LXK-98/ipod-classic-reverse-engineering/captures/INDEX.md

# Capture index

Generated by `tools/index_captures.py`. Do not edit by hand.

Captures are stored gzipped (~110:1); every tool loads `.csv` and `.csv.gz`
interchangeably via `tools/capio.py`. Each has a `.json` sidecar recording the
full settings, the probe-map version in force, and a free-text note.

Filenames all carry the `dryrun` preset name because every capture was driven
through that preset with explicit overrides — it is **not** an indication that
the capture is a throwaway. Read the note column.

| capture | rate | ch | samples | bursts | purpose |
|---|---:|---:|---:|---:|---|
| `20260726_171535_dryrun` | 1 MS/s | 2 | 4608 | 1 | Phase 0 pipeline validation. Pico GP15(50pct)->CH1, GP14(25pct)->CH2, GND->GND. Shifter VREF switch=3v3. ModemManager exclusion rule installed. |
| `20260726_171859_dryrun` | 100 MS/s | 2 | 121024 | 1 | 100 MS/s path validation at 1 MHz PWM |
| `20260801_185016_dryrun` | 1 MS/s | 1 | 131024 | 1 | VREF=EXT@1.8V from pin26; GND=pin3; CH1=pin27. Shifter validation, burst envelope. |
| `20260801_185127_dryrun` | 100 MS/s | 1 | 131024 | 1 | pin27 fine structure at 100 MS/s |
| `20260801_191429_dryrun` | 100 MS/s | 22 | 32767 | 1 | Phase 2 survey A: 22 signal pins, 100 MS/s, trigger falling /WR (P27) |
| `20260801_191517_dryrun` | 100 MS/s | 22 | 32576 | 64 | Phase 2 survey B: burst mode, 64 bursts x 508 samples, each armed on falling /WR |
| `20260801_191740_dryrun` | 100 MS/s | 22 | 32767 | 1 | Phase 3: bootloader LCD init capture. Armed before power-on; first falling /WR should be the first write of lcd_init_seq_23. |
| `20260801_192633_dryrun` | 100 MS/s | 24 | 32767 | 1 | Phase 3: bootloader lcd_init_seq_23 capture. 24ch incl. new P30/P32 to hunt the missing bit-4 lane. Armed with iPod OFF; first falling /WR = first … |
| `20260801_193606_dryrun` | 100 MS/s | 24 | 32754 | 7 | Phase 3: LCD wake init (seq_awake = lcd_init_seq_23, 152 writes). 7 bursts: 6 consumed by the NOP prefix, 7th should catch the register block start… |
| `20260801_194824_dryrun` | 100 MS/s | 24 | 32754 | 7 | Phase 3 retry after reseating probes: confirm bits 3,4,5,15 and test whether P09==P14 persists (solder-bridge vs miswire). |
| `20260801_195303_dryrun` | 100 MS/s | 24 | 32754 | 7 | Swap test: pin21 moved from CH15 to CH17 (known-good, previously pin23/bit2). CH15 now unconnected. If P21b shows bit4, the CH13-16 shifter group i… |
| `20260801_200739_dryrun` | 100 MS/s | 24 | 32754 | 7 | LA-B (serial 5033592712586E1F) full 24ch wake init. Expect 11 known lanes to re-match plus bits 3 and 5 on pins 22/20 if LA-B is healthy. |
| `20260801_212943_dryrun` | 100 MS/s | 24 | 32576 | 64 | Post-reflow check: burst capture of ordinary screen activity. D/C (P28, CH21) must toggle if the CH21-24 group is alive. |
| `20260801_213713_dryrun` *(failed, no data)* | 100 MS/s | 24 | 32576 | 64 | Phase 5 colour fill RED, forced redraw by navigation. Expect dominant pixel word 0xF800. |
| `20260801_214113_dryrun` | 100 MS/s | 24 | 32576 | 64 | Phase 5 RED fill retry. Expect dominant data word 0xF800; first real test of predicted bits 14,15 (pins 9,10) and 6 (pin 19). |
| `20260801_215011_dryrun` | 100 MS/s | 24 | 32576 | 64 | Phase 5 GREEN fill: expect 0x07E0 (bit10=1, bit15=0). Discriminates whether pins 9 and 14 are genuinely tied. |
| `20260801_215055_dryrun` | 100 MS/s | 24 | 32576 | 64 | Phase 5 GREEN fill retry (screen currently blue). Expect 0x07E0: bit10=1 AND bit15=0 - the only stimulus that separates pins 9 and 14. |
| `20260801_220743_dryrun` | 100 MS/s | 24 | 32576 | 64 | Phase 5 WHITE fill (0xFFFF): every RGB666 lane should be driven high. Tests all 18 data lanes in the high state, incl. P02. |
| `20260801_220922_dryrun` | 0.2 MS/s | 24 | 32767 | 1 | SLOW WIDE survey at 200 kS/s = 164 ms. Purpose: /CS envelope between bursts, TE period (~66Hz). /WR WILL alias at this rate - do not read fast-sign… |
| `20260801_221938_dryrun` | 20 MS/s | 24 | 32767 | 1 | Frame strip capture: 20 MS/s (guarantees >=1 sample in the 70-80ns /WR low), 32767 samples = 1.64ms = ~2686 pixels = ~8 rows of 320. Reconstruct wi… |
| `20260801_222018_dryrun` | 20 MS/s | 24 | 32767 | 1 | Frame strip retry, display already awake. Scroll the menu to force full redraws. |
| `20260801_222140_dryrun` | 20 MS/s | 24 | 32767 | 1 | Frame strip, LCD sleep disabled so no wake-init prefix. Scroll menu for full redraws. |
| `20260801_222235_dryrun` *(failed, no data)* | 20 MS/s | 24 | 32767 | 2 | Frame strip via 2 bursts x 16383 @20MS/s. Burst 1 absorbs window-setup + memcpy gap; burst 2 should land mid-pixel-stream giving ~1343 contiguous p… |
| `20260801_222433_dryrun` | 20 MS/s | 24 | 32766 | 2 | Frame strip, 2 bursts x 16127 @20MS/s, pre=512 (pre=1 appears to be below the device minimum and never completed). |
| `20260801_222550_dryrun` | 20 MS/s | 24 | 32766 | 1 | Mid-frame strip: contiguous capture armed during continuous scrolling, so the trigger lands on a random pixel mid-frame rather than on the window s… |
| `20260801_223230_dryrun` | 100 MS/s | 24 | 32576 | 64 | INDIGO fill (75,0,130): R5=9=01001, G6=0, B5=16=10000. Determines the blue MSB and constrains red's within-field bit order. |
| `20260801_223514_dryrun` | 100 MS/s | 24 | 32576 | 64 | VIOLET fill (238,130,238): R5=29, G6=32=100000 (ONE green lane high = the green MSB), B5=29. Determines the GREEN within-field bit order. |
| `20260801_223723_dryrun` | 100 MS/s | 24 | 32576 | 64 | ORANGE fill (255,165,0): R5=31->63, G6=41=101001 (positions 5,3,0), B5=0. Resolves which of P01/P18 sits at green position 3 and which of P16/P19/P… |
| `20260801_224147_dryrun` | 100 MS/s | 24 | 32576 | 64 | Custom background R=0 G=16 B=0 (RGB565 units). G6=16=010000 -> exactly one green lane high = the position-4 pin. Resolves P16 vs P19. |
| `20260801_224807_dryrun` | 100 MS/s | 24 | 32576 | 64 | Green status bar at row 0. If it is the R=0 G=16 B=0 setting, exactly one green lane should be high = the position-4 pin, resolving P16 vs P19. |
| `20260802_124256_dryrun` ⛔ **INVALID — EXCLUDE FROM SWEEPS** | 100 MS/s | 24 | 32576 | 64 | **VREF on the 3v3 switch position put the TXU0104 threshold (V(T+) max 1.92 V) above a 1.8 V logic high. 18 of 24 channels read constant 0 with zero edges; the data bus is unreadable. The capture reports success and returns plausible-looking values, so it must be EXCLUDED from any content sweep. See FINDINGS 'A level shifter referenced too high fails silently'. Demonstrated 2026-10-12: including this file in a pair-replication sweep produced 29 spurious blue-pair splits.** |
| `20260802_125222_dryrun` *(failed, no data)* | 1 MS/s | 24 | 32766 | 1 | COLD BOOT /RESET hunt. VREF from a 1k/1k divider off the analyzer 3v3 (1.6V, independent of the target). Armed with the iPod OFF; trigger on P30 fa… |
| `20260802_125453_dryrun` *(failed, no data)* | 1 MS/s | 24 | 32766 | 1 | COLD BOOT /RESET hunt, attempt 2: trigger on P32 falling. P30 did not pulse on a cold boot. VREF from 1k/1k divider off analyzer 3v3 (1.6V). |
| `20260802_125835_dryrun` *(failed, no data)* | 1 MS/s | 24 | 32766 | 1 | COLD BOOT rising-edge timing. Both P30 and P32 sit at 0V while the iPod is off and rise at power-on; a falling-edge trigger could never fire (desig… |
| `20260802_130138_dryrun` *(failed, no data)* | 1 MS/s | 24 | 32766 | 1 | COLD BOOT, trigger on /CS (P29) falling = first LCD transfer, with 30ms PRE-TRIGGER. Captures the state of P30/P32 throughout power-up rather than … |
| `20260802_130335_dryrun` | 100 MS/s | 24 | 32576 | 64 | VALIDATION: does the analyzer read the bus correctly with VREF from the 1k/1k divider (1.6V)? Decode the window-setup commands to confirm before sp… |
| `20260802_130459_dryrun` *(failed, no data)* | 1 MS/s | 24 | 32766 | 1 | COLD BOOT retry, rig now VALIDATED (window-setup commands decode byte-exactly at VREF=1.6V from the divider). Trigger /CS falling, 30ms pre-trigger… |
| `20260802_131144_dryrun` | 100 MS/s | 24 | 32576 | 64 | Post-restore validation (retry after the analyzer dropped off USB). VRF back on pin 26, P07 back on CH3, switch on EXT. |
| `20260802_131348_dryrun` | 20 MS/s | 24 | 32766 | 2 | Final frame reconstruction. 2 bursts x 16127 @20MS/s: burst 1 absorbs the window setup and the memcpy gap, burst 2 lands mid-pixel-stream for ~1340… |
| `20260803_203836_init-burst` | 20 MS/s | 24 | 32764 | 10 | Full 152-write wake init. 10 bursts @20MS/s: 6 NOPs, the 140-write register block, and the 3 trailing pairs after the 30/60/150ms sleeps. |
| `20261012_154402_power-seq` *(failed, no data)* | 1 MS/s | 8 | 131071 | 1 | STAGE 0 pipeline validation, NOT real data. iPod OFF, VRF from 1k/1k divider off analyzer 3v3 (1.6V), switch EXT. Trigger ch0 driven by a manual ju… |
| `20261012_161426_power-seq` *(failed, no data)* | 1 MS/s | 8 | 131071 | 1 | STAGE 0 RIG VALIDATION, not power-seq data despite the preset name. iPod ON (battery, charger out), live screen traffic. VRF from 1k/1k divider off… |
| `20261012_161634_power-seq` | 1 MS/s | 8 | 131071 | 1 | STAGE 0 RIG VALIDATION retry with pre=1024. iPod ON (battery), scrolling. Same rig as the three preceding no-fire attempts; ONLY pre-trigger size c… |
| `20261012_161748_blit-timing` | 20 MS/s | 24 | 32767 | 1 | STAGE 0 RIG VALIDATION, exact replication of the proven 20260801_221938 config (20 MS/s, pre 512, post 32255, 24ch, trigger ch19=P27=/WR falling). … |
| `20261012_165816_power-seq` | 0.1 MS/s | 24 | 32767 | 1 | PRE-FLIGHT after rewiring rails onto silkscreen CH2/CH9/CH19 (pins 26/33/34), retry after the analyzer was unplugged by the operator during rewirin… |
| `20261012_170354_power-seq` | 0.1 MS/s | 24 | 32767 | 1 | GAP 1: RAIL POWER-UP SEQUENCING, first ever capture of pins 26/33/34. Cold start by BATTERY RECONNECT with the iPod previously off and the battery … |
| `20261012_171110_power-seq` | 0.1 MS/s | 24 | 32767 | 1 | GAP 1 REPRODUCIBILITY CHECK, identical method to 20261012_170354: iPod powered off then battery removed, capture armed with all rails at 0, cold st… |
| `20261012_171537_power-seq` | 0.1 MS/s | 24 | 32767 | 1 | GAP 1 REPEAT via HOLD-SWITCH cold start, a better method than battery reconnect. Sequence: battery out -> hold switch LOCKED -> battery in (firmly … |
| `20261012_172903_power-seq` | 0.025 MS/s | 24 | 32767 | 1 | GAP 2: rail to first command. 25 kS/s x 32767 = 1.31 s window (20.5ms pre, 1290ms post) at 40us resolution, same wiring as gap 1, trigger = 3.0V ra… |
| `20261012_210039_power-seq` *(failed, no data)* | 0.005 MS/s | 24 | 32767 | 1 | POWER-DOWN SEQUENCING, first ever capture of this. 5 kS/s x 32767 = 6.55 s window (102ms pre, 6451ms post) at 200us resolution. Trigger = VDDIO (V1… |
| `20261012_210640_power-seq` | 0.025 MS/s | 24 | 32767 | 1 | POWER-DOWN SEQUENCING, first ever capture of this. 25 kS/s (the slowest rate this project has actually got data from; 5 kS/s silently failed to arm… |

## ⛔ Captures that must be excluded from analysis

These completed successfully and contain plausible-looking data that is
nonetheless wrong. Nothing about the capture itself signals this, so any
content sweep must skip them — use `capio.invalid_reason()`.

- **`20260802_124256_dryrun`** — VREF on the 3v3 switch position put the TXU0104 threshold (V(T+) max 1.92 V) above a 1.8 V logic high. 18 of 24 channels read constant 0 with zero edges; the data bus is unreadable. The capture reports success and returns plausible-looking values, so it must be EXCLUDED from any content sweep. See FINDINGS 'A level shifter referenced too high fails silently'. Demonstrated 2026-10-12: including this file in a pair-replication sweep produced 29 spurious blue-pair splits.
