LXK-98/ipod-classic-reverse-engineering/hardware/interposer/display-analyzer-board.kicad_pcb

## KiCad design hardware/interposer/display-analyzer-board.kicad_pcb (2026-08-01)

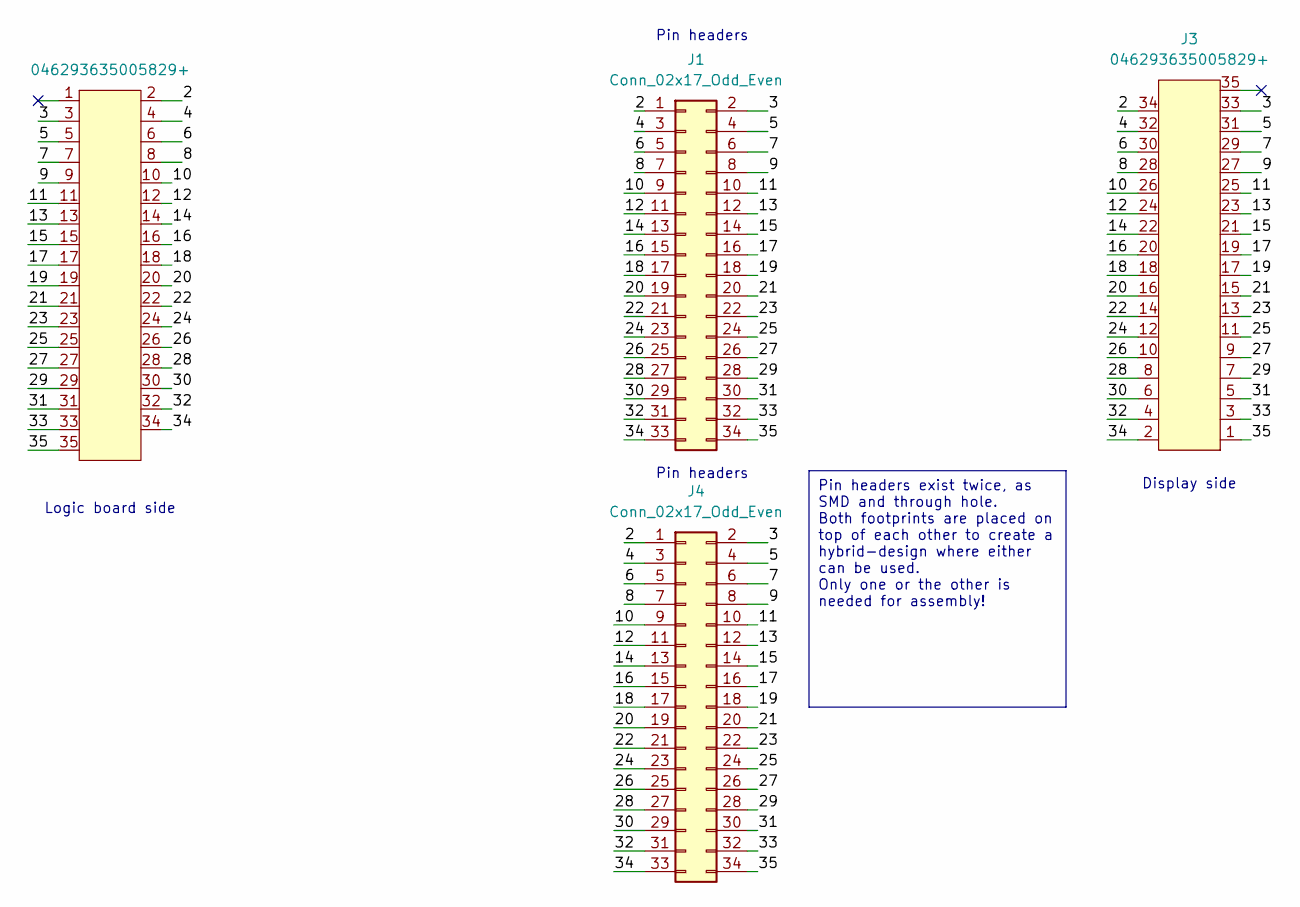
[picture p1: schematic display-analyzer-board.kicad_sch, iPod Classic 7 Gen Display signal interceptor board]

Parts:
J1: Conn_02x17_Odd_Even; PinHeader_2x17_P2.54mm_Vertical_SMD
J2, J3: 046293635005829+
J4: Conn_02x17_Odd_Even; PinHeader_2x17_P2.54mm_Vertical

Connections:
/2: J1.1, J2.2, J3.34, J4.1
/3: J1.2, J2.3, J3.33, J4.2
/4: J1.3, J2.4, J3.32, J4.3
/5: J1.4, J2.5, J3.31, J4.4
/6: J1.5, J2.6, J3.30, J4.5
/7: J1.6, J2.7, J3.29, J4.6
/8: J1.7, J2.8, J3.28, J4.7
/9: J1.8, J2.9, J3.27, J4.8
/10: J1.9, J2.10, J3.26, J4.9
/11: J1.10, J2.11, J3.25, J4.10
/12: J1.11, J2.12, J3.24, J4.11
/13: J1.12, J2.13, J3.23, J4.12
/14: J1.13, J2.14, J3.22, J4.13
/15: J1.14, J2.15, J3.21, J4.14
/16: J1.15, J2.16, J3.20, J4.15
/17: J1.16, J2.17, J3.19, J4.16
/18: J1.17, J2.18, J3.18, J4.17
/19: J1.18, J2.19, J3.17, J4.18
/20: J1.19, J2.20, J3.16, J4.19
/21: J1.20, J2.21, J3.15, J4.20
/22: J1.21, J2.22, J3.14, J4.21
/23: J1.22, J2.23, J3.13, J4.22
/24: J1.23, J2.24, J3.12, J4.23
/25: J1.24, J2.25, J3.11, J4.24
/26: J1.25, J2.26, J3.10, J4.25
/27: J1.26, J2.27, J3.9, J4.26
/28: J1.27, J2.28, J3.8, J4.27
/29: J1.28, J2.29, J3.7, J4.28
/30: J1.29, J2.30, J3.6, J4.29
/31: J1.30, J2.31, J3.5, J4.30
/32: J1.31, J2.32, J3.4, J4.31
/33: J1.32, J2.33, J3.3, J4.32
/34: J1.33, J2.34, J3.2, J4.33
/35: J1.34, J2.35, J3.1, J4.34

Notes on the sheet:
Pin headers exist twice, as SMD and through hole. Both footprints are placed on top of each other to create a hybrid-design where either can be used. Only one or the other is needed for assembly!
Pin headers
Display side
Logic board side

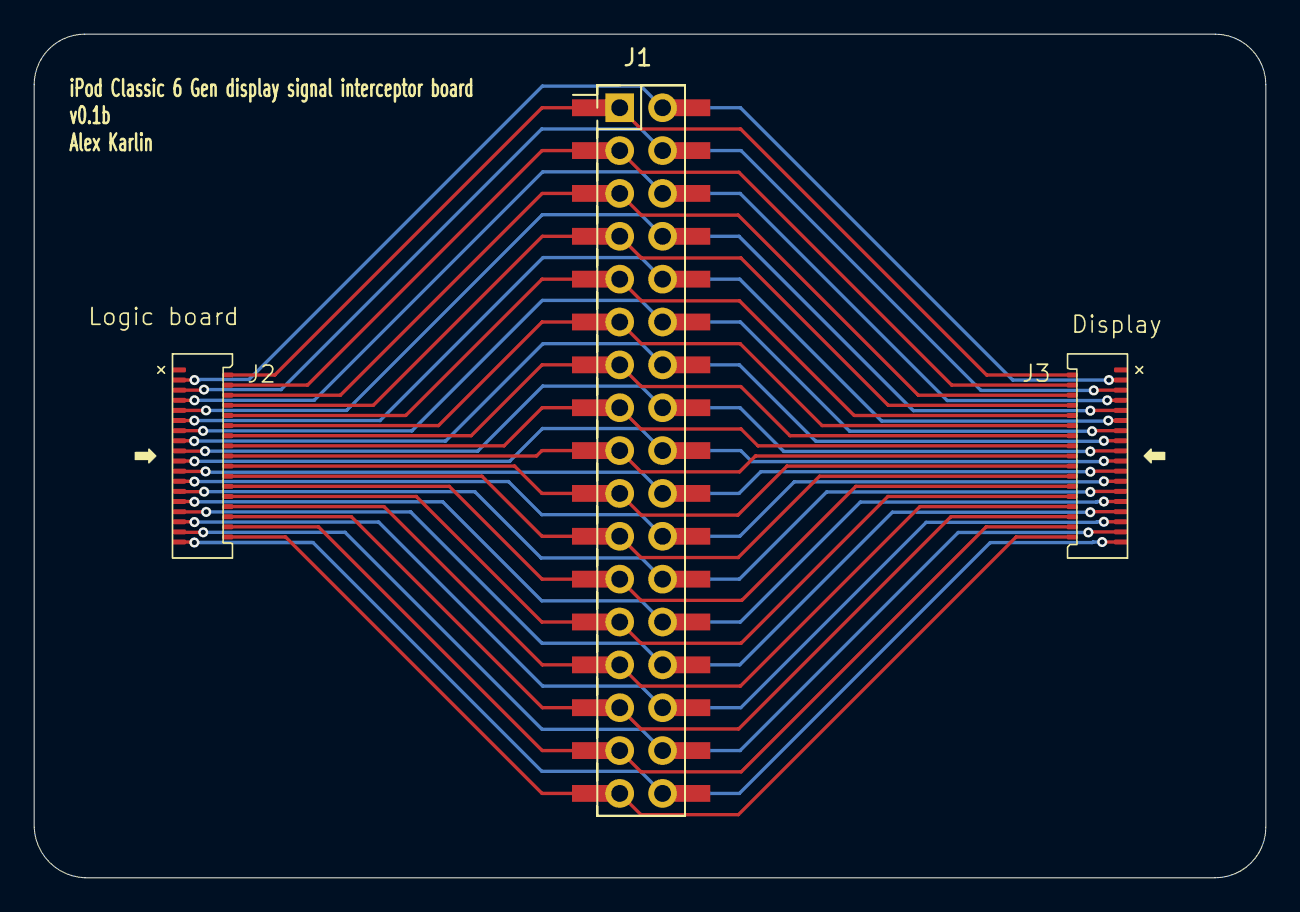
[picture p2: board display-analyzer-board.kicad_pcb from above]

Board: 2 copper layers, 73.0 x 50.0 mm, 4 parts (0 on the bottom side), 34 nets.
