LXK-98/ipod-classic-reverse-engineering/tools/index_captures.py

#!/usr/bin/env python3
# SPDX-License-Identifier: MIT
"""Regenerate captures/INDEX.md from the capture sidecars.

Capture filenames are timestamps and carry no meaning; the sidecar JSON records
what each one was for, the settings used, and the probe map in force. This turns
that into a readable table so the evidence set is navigable.
"""
from __future__ import annotations

import json
from pathlib import Path

REPO = Path(__file__).resolve().parent.parent
CAP = REPO / "captures"


def main() -> int:
    rows = []
    for j in sorted(CAP.glob("*.json")):
        d = json.loads(j.read_text())
        s = d.get("session", {})
        stem = j.stem
        data = next((p.name for p in (CAP / f"{stem}.csv.gz", CAP / f"{stem}.csv") if p.exists()), None)
        n_ch = len(s.get("CaptureChannels", []))
        total = s.get("PostTriggerSamples", 0) * (s.get("LoopCount", 0) + 1) + s.get("PreTriggerSamples", 0)
        rows.append({
            "id": stem,
            "ok": bool(data),
            "rate": s.get("Frequency"),
            "ch": n_ch,
            "samples": total,
            "bursts": s.get("LoopCount", 0) + 1,
            "note": (d.get("note") or "").strip(),
            "probe_map": d.get("probe_map", ""),
            "invalid": bool(d.get("invalid")),
            "invalid_reason": (d.get("invalid_reason") or "").strip(),
        })

    out = ["# Capture index", "",
           "Generated by `tools/index_captures.py`. Do not edit by hand.", "",
           "Captures are stored gzipped (~110:1); every tool loads `.csv` and `.csv.gz`",
           "interchangeably via `tools/capio.py`. Each has a `.json` sidecar recording the",
           "full settings, the probe-map version in force, and a free-text note.", "",
           "Filenames all carry the `dryrun` preset name because every capture was driven",
           "through that preset with explicit overrides — it is **not** an indication that",
           "the capture is a throwaway. Read the note column.", "",
           f"| capture | rate | ch | samples | bursts | purpose |",
           "|---|---:|---:|---:|---:|---|"]
    for r in rows:
        rate = f"{r['rate']/1e6:g} MS/s" if r["rate"] else "—"
        note = r["note"].replace("|", "/")
        if len(note) > 150:
            note = note[:147] + "…"
        mark = "" if r["ok"] else " *(failed, no data)*"
        if r["invalid"]:
            mark = " ⛔ **INVALID — EXCLUDE FROM SWEEPS**"
            note = f"**{r['invalid_reason'].replace('|', '/')}**"
        out.append(f"| `{r['id']}`{mark} | {rate} | {r['ch']} | {r['samples']} | "
                   f"{r['bursts']} | {note} |")
    out.append("")

    bad = [r for r in rows if r["invalid"]]
    if bad:
        out += ["## ⛔ Captures that must be excluded from analysis", "",
                "These completed successfully and contain plausible-looking data that is",
                "nonetheless wrong. Nothing about the capture itself signals this, so any",
                "content sweep must skip them — use `capio.invalid_reason()`.", ""]
        for r in bad:
            out.append(f"- **`{r['id']}`** — {r['invalid_reason']}")
        out.append("")

    (CAP / "INDEX.md").write_text("\n".join(out) + "\n")
    ok = sum(1 for r in rows if r["ok"])
    n_bad = len(bad)
    extra = f", {n_bad} INVALID (exclude from sweeps)" if n_bad else ""
    print(f"wrote captures/INDEX.md — {len(rows)} sidecars, {ok} with data{extra}")
    return 0


if __name__ == "__main__":
    raise SystemExit(main())
