LXK-98/ipod-classic-reverse-engineering/(commit log)

2026-07-26 Phase 0: repo scaffold, Rockbox ground truth, capture toolchain
    - refs/: Rockbox lcd-6g.c, lcd-s5l8702.c + headers (pinned by sha256)
    - tools/rockbox_seq.py: expands init/sleep/awake sequences to byte-exact
    bus transactions for all 4 panel types x 2 build configs
    - tools/capture.py: TerminalCapture wrapper (CLCapture is gone in v6.0.0.1)
    - pinout.json v0, findings.md
2026-07-26 Phase 0 complete: pipeline validated against known signal
    - classify.py: per-channel stats, whole-cycle duty, median pulse widths
    - picogen.py: persistent main.py generator (PWM was being GC-deinited)
    - docs/99-bench-instruments.rules: ModemManager was wedging BOTH instruments
    - acceptance: 10kHz and 1MHz references match at 0.000% freq error
    [capture.py, classify.py, picogen.py]
2026-08-01 Fix pin convention from interposer KiCad: flex is 34-pin, not 33
    Parsed the collaborator's own board netlist. Connectors are 35-position
    with the topmost unused; all 34 routed nets /2../35 are live.
    FLEX pin N = header pin N = net /(N+1), N = 1..34
    header pin 1 = TOP-LEFT, odd = left column, even = right
    Corrects the project brief's 33-pin figure and rebuilds pinout.json.
    [display-analyzer-board.kicad_pcb, display-analyzer-board.kicad_sch]
2026-08-01 Untrack KiCad caches, backups and embedded .history repo
2026-08-01 Phase 1: ground reference established, two distinct grounds found
    Signal ground (HDD case + several LCD flex pins, mutually ~0 ohm) is
    bonded to chassis ground (dock shell, rear shell) through ~300 ohm.
    Contact resistance ruled out: both metals read ~0 ohm across themselves.
    Consequence: analyzer ground must go to signal ground (a GND pin on the
    interposer header), not chassis, or 300 ohm sits in the return path.
2026-08-01 Phase 1: ground sweep shows clear pin clustering
    GND = 3,6,8,17,31. Pin 5 at 25.6 ohm = backlight cathode candidate.
    17 pins share an identical 3.7-3.8M leakage (data bus?), 6 pins sit at
    0.5-0.6M (control set is exactly 6 signals). Budget closes at 34.
    Also: beeper mode hid all structure above ~50 ohm; resistance-range
    readings supersede it. tools/record_dmm.py ingests sweeps to pinout.json.
    [2026-08-01_ground-sweep.tsv]
2026-08-01 Phase 1: backlight identified (pin 4 = 10.7V), VDDIO ~1.8V
    SAFETY: pin 4 is the backlight anode at 10.7V and must never touch an
    analyzer input (TXU0104 A-side max 5.5V). Rule 1 satisfied.
    VDDIO ~1.8V trips the brief's 2.3V gate. Shifter VREF MUST move from
    3v3 to EXT: at VCCI=3V the TXU0104 VT+ max is 1.92V, above a 1.8V
    logic high, so probing on 3v3 would give intermittent wrong data.
    Pin structure now closes: 18 bus + 4 active-low control + 5 GND +
    4 rails + BL+ + 1 unresolved = 34.
    [2026-08-01_powered-sweep.tsv]
2026-08-01 Phase 1 complete: /WR identified on pin 27, bus timing measured
    VREF=EXT@1.8V validated. Pin 27 = /WR: 70-80ns low, 530-540ns high,
    610ns cycle, 1.64 MHz. Burst span 46.92ms vs 76800 px x 610ns =
    46.85ms (0.1% match) => full-frame update, ONE transfer per pixel,
    confirming LCD_MODE_P16 RGB565/1-transfer which Rockbox marks TBC.
    Also recorded: a 1 MS/s capture aliased 1.64 MHz into a fake, very
    regular 91 kHz. Run-length regularity is NOT evidence against
    aliasing - the survey preset's 10 MS/s would have mis-measured this.
2026-08-01 First real bus decode: D/C found, 3 lanes mapped, bit-4 lane missing
    Caught displaylcd_setup() (13 writes = 6 reg+data pairs + bare 0x202).
    P28 = D/C (0=cmd, 1=data). P25=bit0, P24=bit1, P15=bit9 from the seven
    known command words.
    ANOMALY: bit 4 (signature 1111000 over the commands) appears on no
    probed pin. Hypothesis: one of pins 26/30/32, classified as 1.8V rails
    from DMM, is a mostly-high data lane - bursts are only 4.7% of wall
    time so a DMM averages such a lane to ~1.8V.
    Also flagged: P15 as 'bit 9' is degenerate with 'inverted D/C' in this
    sequence; the init sequence breaks the tie.
2026-08-01 Cold-boot capture fails: VREF is derived from the target's own rail
    All 24 channels flat zero. With the iPod off, pin 26 (VRF source) is
    0V, so TXU0104 Ioff-float forces outputs high-Z and the collapse itself
    trips the falling-edge trigger.
    Fix: trigger the init via LCD sleep/wake (Rockbox
    lcd_sleep_after_backlight_off) with the iPod powered throughout. Type 2
    sets seq_awake = lcd_init_seq_23, so waking replays a full 152-write
    init with a 6x NOP prefix signature.
    Fallback if the rail drops during sleep: divider from analyzer 3v3.
2026-08-01 LANE MAP SOLVED: 10 data lanes + D/C + /WR matched exactly
    Wake capture came out exactly as designed: bursts 1-6 = one NOP each,
    burst 7 = 69 consecutive register writes. Matched against
    lcd_init_seq_23 (firmware) with 2^-69 false-match probability.
    bit0=p25 bit1=p24 bit2=p23 bit7=p18 bit8=p16 bit9=p15
    bit10=p14 bit11=p13 bit12=p12 bit13=p11
    /WR=p27 D/C=p28 (0=cmd, 1=data)
    All fit a monotonic descending pin->bit run that skips GND pins 17/8,
    predicting p22..p19 = bits 3..6 and p10/p9 = bits 14/15.
    P15 degeneracy resolved: genuinely bit 9, not inverted D/C.
    Two wiring faults isolated: P09==P14 byte-identical (CH4 landed on
    pin 14), and pins 20/21/22 read constant 0 though bits 5/4/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
2026-08-01 Reseat changes nothing: probe-path fault, likely one dead TXU0104
    Bit-identical re-capture rules out intermittent contact. The powered
    DMM sweep already showed pins 19-22 toggling, so the interposer is
    fine and the break is between header and analyzer.
    CH13-16 are exactly one 4-bit TXU0104 group (6 chips x 4 = 24ch), and
    all four fail together - consistent with an unsoldered VCC/GND on one
    device, whose Ioff-float behaviour gives clean constant 0.
    Channels proven good by exact ground-truth match: CH6-12, CH17-21.
    P09==P14 still unexplained; does not fit the dead-group theory.
2026-08-01 Swap test: dead TXU0104 confirmed, pin21=bit4 verifies predicted map
    Pin 21 reads constant 0 on CH15 but matches bit4 EXACTLY on CH17.
    CH13-16 is one 4-bit TXU0104 group => one dead translator, not a
    board or probe fault.
    pin21=bit4 was PREDICTED by the monotonic pin->bit rule and verified
    exactly; the rule now has 11 confirmed instances, 0 exceptions.
    Unconnected CH15 read 0/68 ones, proving floating channels read zero
    rather than mirroring - which rules out crosstalk for P09==P14.
2026-08-01 LA-B: bits 3,5 confirmed; both analyzers have a dead TXU0104 group
    P22=bit3, P20=bit5 exact matches. All 13 bits the init can exercise
    are now confirmed, vindicating the dead-CH13-16 diagnosis.
    LA-B has its own dead group CH21-24 (P30/P32 read const 1 on LA-A but
    const 0 here - dead channel, not changed signal). Neither is blocking:
    20 good channels covers 18 data + WR + DC.
    P09==P14 persists across a different analyzer with re-run wiring.
    Remaining: bits 6/14/15 need colour fills - they are constant zero in
    the entire init sequence, as predicted from source.
2026-08-01 Analyzer repaired: OE cold joint on pin 8, reflow fixed it
    Supplies measured 3.3V everywhere, ruling out unsoldered VCC. Traced
    instead to OE (pin 8), which gates ALL FOUR outputs high-Z when
    floating - matching the dead-group-of-4 signature exactly. OE sits
    next to GND at one end of the TSSOP, the corner drag-soldering
    skimps.
    Post-reflow: P28/P29 alive; P30/P32 read const 1, matching LA-A's
    reading of the same pins when healthy. LA-B now has all 24 channels.
    Also recorded the V2 chip->channel map, which is NOT in sequential
    physical order: U1,U4,U6,U5,U3,U2 top-to-bottom = CH1-4, 21-24, 5-8,
    17-20, 9-12, 13-16.
2026-08-01 Colour fills: bit 6 confirmed, bit 10 anomaly is real and reproducible
    Lamp plugin palette is hard-coded, so expected words are exact.
    Blue decodes exactly 0x001F. Red and green are each wrong by exactly
    one bit - bit 10 - in opposite directions. No palette colour produces
    the observed words, so the reading is corrupted, not the colour.
    Red and green are the ONLY lamp colours where bit15 != bit10, and both
    show pin 14 taking pin 9's value.
    Unexplained contradiction: a short with bit15 winning fits the fills
    but not the init, where bit15 is constant 0 yet P09/P14 tracked the
    varying bit 10 across 68 writes.
    bit 6 = pin 19 CONFIRMED (0x00EF decodes correctly only with it).
    [decode8080.py]
2026-08-01 The bus is RGB666, not RGB565 - bit-10 anomaly was my analysis error
    Pins 9/14 measure 6.66M (open) and wiring is confirmed correct, ruling
    out hardware. Solved frame-mode mapping empirically from the lamp
    fills instead: red/green/blue each drive exactly SIX lanes.
    RED pins 9,10,11,12,13,14
    GREEN pins 1,15,16,18,19,20
    BLUE pins 2,21,22,23,24,25
    I had decoded pixels with the 16-bit command-mode map, which is the
    wrong model and manufactured a phantom one-bit error in exactly the
    two fills where the fields disagree.
    P09==P14 is the red channel's 5->6 expansion duplicate. Predicted a
    blue duplicate too; there is none, so the expansion is asymmetric and
    the model is incomplete.
    Cont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
2026-08-01 White fill closes the 18-lane RGB666 inventory (6/6/6)
    All 18 data lanes high on white, including P02. Lanes now observed in
    both states. P07/P29/P30/P32 did not follow the pixel data.
    32 of 34 pins assigned. Only 7 and 29 unassigned - but four control
    signals remain to place, so the 'rail' classification of pins 30/32 is
    likely wrong: an idle-high control line reads a steady 1.8V on a DMM.
    Pin 7 = TE hypothesis: the first powered sweep saw ~15ms (~66Hz)
    spikes there, a panel refresh rate. Pin 29 constant-low fits /CS.
2026-08-01 PINOUT COMPLETE: TE on pin 7, /CS on pin 29, all 34 pins assigned
    Slow 200 kS/s survey exposed the signals that are constant inside a
    325us burst window:
    pin 7 = TE - 60us pulse every 14.72ms = 67.9 Hz (refresh rate)
    pin 29 = /CS - idles high, low envelopes framing write bursts
    pins 30,32 = /RD and /RESET by elimination (order undetermined)
    Adds tools/report.py, which regenerates PINOUT.md from pinout.json.
    28 pins high confidence, 5 medium, 1 low (pin 34 analog node).
    [report.py]
2026-08-01 Add frame2png.py: reconstructs images from captures, validates protocol
    Decoder reproduces the lamp plugin's colours byte-exactly on all four
    fills (red/green/blue/white -> pure RGB888). Validates pin assignment,
    RGB666 field mapping, /WR latch edge and D/C polarity by
    reconstruction rather than pattern matching.
    Recovers the update rect from the 0x210-0x213 window commands, so
    geometry comes from the capture. PNG written with stdlib zlib only.
    Full frames are out of reach: 46.9ms at >=20 MS/s needs ~940k samples
    vs 131k max, short by ~7x. Partial strips work fine.
    [frame2png.py]
2026-08-01 P09==P14 SOLVED: P14 is a hardware replica of the red MSB
    Collaborator reported the screen top is grey; we decoded green. Saturated
    fills cannot validate bit order WITHIN a field - that had been assumed.
    Indigo (non-saturated: R5=01001, B5=10000) shows both 5-bit channels
    gaining one extra high lane => the 5->6 expansion replicates the MSB
    into the LSB: 6bit = (5bit<<1)|(5bit>>4)
    RED = P09 P10 P11 P12 P13 P14 (P14 replicates P09)
    BLUE = P21 P22 P23 P24 P25 P02 (P02 replicates P21)
    This resolves P09==P14 completely: not a short, not a miswire, not
    crosstalk. P14 carries a hardware copy of P09. It also explains the
    command-vs-frame contradiction (P14 = APB bit 10 in command mode,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
    [frame2png.py]
2026-08-01 Backlight fully characterised: 19.5 mA into ~3 white LEDs
    500 mV flat across the 25.6 ohm sense resistor at max brightness =
    19.53 mA true DC current (flat => 100% duty). At brightness 7, 27.1 mV
    = 1.06 mA average at ~5.4% duty, same peak.
    => dimming is PWM at constant peak current; colour temperature stays
    constant. Brightness curve is perceptual (gamma ~1.3), not linear.
    String: 10.7V anode - 0.5V sense = ~10.2V => ~3 white LEDs in series.
    Phase 6 spec: constant-current boost, ~20 mA, >=11 V compliance, PWM
    dimming. Deliverable #3 complete.
2026-08-01 Fix report.py after backlight data restructure
    [report.py]
2026-08-01 Correction: backlight is 4 LEDs, not 3 (anode is 12.76V at full brightness)
    Re-read pin 4 at brightness 63: 12.76 V, vs 10.7 V at brightness 7.
    Minus the 0.50 V sense drop leaves 12.26 V across the string:
    4 LEDs -> 3.07 V each (textbook white-LED Vf at 20 mA)
    3 LEDs -> 4.09 V each (out of range)
    The earlier 3-LED estimate came from the 10.7 V reading taken at ~5%
    duty, where the boost is lightly loaded - a component count derived
    from the wrong operating point.
    Also: the anode stays up at low duty, so PWM switches the LOW side.
    Driver spec now: ~20 mA into a 4-LED string, >=14 V compliance.
2026-08-01 Reorganise as a publishable project with full documentation
    Documentation:
    README.md front door: results, layout, quick start, safety
    docs/HARDWARE.md target, interposer, instrumentation, safety rules
    docs/PROTOCOL.md bus protocol, init sequences, timing, pixel format
    docs/METHODOLOGY.md how each result was obtained and how to reproduce
    docs/FINDINGS.md notable findings incl. contradictions with Rockbox
    docs/OPEN-QUESTIONS.md what remains unresolved
    docs/LAB-NOTEBOOK.md full chronological log (was findings.md)
    Structure:
    display-analyzer-board/ -> hardware/interposer/
    captures gzipped (37 MB -> 456 KB, ~110:1) with transparent .gz suppor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
    [display-analyzer-board.kicad_pcb, display-analyzer-board.kicad_sch]
2026-08-02 Pin 34 RESOLVED: analog reference INPUT, ~1.54 V, board-supplied
    With the display flex disconnected the logic board still holds pin 34
    at ~1.54 V, so the panel receives it rather than generating it. A
    replacement driver must supply it.
    Also: everything previously reported as activity on this pin - a
    '~80 us square wave', '~12.5 kHz ripple', a 125 Hz readout and bursts
    of ringing - was CHARGER NOISE. It vanishes on battery and returns when
    charging. The pin carries no signal.
    The tell in hindsight: a signal whose apparent period changes with the
    timebase you view it at is not a signal. Recorded as finding 11 -
    take analog measurements on battery power.
2026-08-02 Soft reset does not assert the panel reset line
    Armed on P30 then P32, falling edge, 32.7ms window with 8ms pre-trigger,
    Menu+Select reboot each time. Neither pulsed.
    => the panel's reset is asserted only at cold power-on (PMU rail
    sequencing), not by the SoC on a warm reboot. A replacement driver must
    therefore drive reset itself at power-up.
    Also recorded: a resistive divider cannot supply VREF for a cold-boot
    capture. It reads 0.60 V - a junction drop - because with the iPod
    powered down the TXU0104 A-side inputs are clamped to a dead board,
    presenting ~2.9 kohm on VCCA. Needs a stiff source (LDO or shunt
    reference), not a divider.
2026-08-02 VREF at 3v3 fails quietly: 18 of 24 channels read constant zero
    Tested the switch on 3v3 (which would have solved the cold-boot VREF
    problem) against known traffic. The entire data bus reads flat zero -
    at VCCI=3.3V the TXU0104 VT+ max is 1.92V, above a 1.8V logic high.
    Failure mode is the notable part: the capture reported success and
    returned plausible values (0x0000, 0x0010) with no error. Only the
    absence of the known window-setup commands revealed it. Testing
    against known-answer data is what caught it.
    Cold boot therefore needs a stiff ~1.8V source: 3x 1N4148 + 1k, a red
    LED + 1k, or a 1.8V LDO. A divider remains ruled out.
2026-08-02 Park /RD vs /RESET after five failed boot captures
    Attempts 1-3 used a falling-edge trigger on lines that sit at 0V while
    the iPod is off and RISE at power-on - a test that could not have
    fired. Attempts 4-5 triggered on /CS falling and also did not fire,
    including one after validating that the rig decodes the window-setup
    commands byte-exactly at VREF=1.6V.
    The /CS non-trigger during cold boot remains UNEXPLAINED: /CS visibly
    frames every write burst when the iPod runs.
    Established along the way:
    - the panel is NOT reset on a warm reboot; a driver must drive reset
    - a 10k divider on VRF fails (0.60V, ~2.9k ESD clamp when target off)
    - a 1k divider holds 1.6V and is validated as a wo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
2026-08-02 Restore documented rig configuration; note analyzer USB drop-outs
    VRF back on header pin 26, P07 back on CH3, switch on EXT. Validated:
    the window-setup commands decode byte-exactly, so the bench matches the
    configuration every documented result was taken with.
    Also recorded: the analyzer dropped off the USB bus twice in one
    session. A capture armed when that happens is indistinguishable from
    'the trigger never fired', which may bear on the inconclusive
    cold-boot attempts. Check --list-ports before treating a non-trigger
    as a fact about the target.
2026-08-02 Add reconstructed status-bar image as end-to-end proof
    Rows 0-3 of a live Rockbox screen decoded from a raw bus capture:
    blue icon, text glyph tops, and the battery outline with its red
    low-charge fill - matching what is physically on the panel.
    57 distinct colours across 1320 pixels, no post-processing. Embedded in
    README and PROTOCOL.md as visual confirmation that the pinout, RGB666
    field mapping, /WR latch edge and D/C polarity are all correct.
2026-08-02 Visual confirmation against the physical panel
    Collaborator confirms the reconstructed strip is recognisable as the
    top of the status bar with correct colours.
    This validates the 34-pin map, RGB666 field assignment AND within-field
    bit order, the /WR latch edge, D/C polarity and the window geometry
    decode simultaneously - an error in any would visibly scramble it.
    Categorically stronger than the earlier checks: those compared captures
    against our own predictions, which share a failure mode where a
    consistent error passes unnoticed. That is how the bit-order bug
    survived nine byte-exact protocol matches.
2026-08-02 Add DRIVING.md: complete Phase 6 implementation guide
    Audited the docs against what building a driver actually requires and
    found gaps. Three were closable from existing 100 MS/s captures without
    touching the bench:
    data setup before the /WR latch: min 30 ns, typically 60-70 ns
    data hold after the latch: min 270 ns
    D/C setup before the latch: min 380 ns
    /CS: held low for the whole burst (99.6% low), not toggled per write
    DRIVING.md collects supplies (incl. the easily-missed 1.54V reference on
    pin 34), reset handling, bus timing, RGB666 format, backlight spec, the
    init sequence with usable pseudocode, the blit procedure, and TE sync.
    It also lists five KNOWN GAPS explici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
2026-08-02 Scope the RGB666 claims to what was actually measured
    Prompted by the fair question: how do we know we are right and Rockbox
    is wrong? Largely we do not - the claim needed narrowing.
    What IS measured: all 18 lanes are observed both high and low across
    solid-colour fills, so none is undriven. That contradicts the
    APB[15:0] -> D[17:10,8:1] description at the level of behaviour, and
    holds regardless of pin naming.
    What was overclaimed and is now corrected:
    - 'Rockbox is wrong' -> that comment block is headed 'XXX: WIP, TBC'
    and their driver is correct regardless; nothing depends on it
    - 'D9 and D0 are driven' -> we have NO mapping from our flex pin
    numbers to the SoC's D0-D17, so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
2026-08-03 Document the burst-sizing tradeoff and the failed init-capture attempts
    The burst-boundary write-drop tradeoff existed only in the lab notebook,
    not in METHODOLOGY where someone repeating the work would look. It is
    the key sizing decision: the device re-arms after each burst and can
    lose a write at every boundary, which destroys alignment for sequence
    matching and shears reconstructed images.
    Also adds an explicit 'attempts that failed' section covering the three
    ways the init capture went wrong: arming before a cold boot (VREF
    collapses with the target), a contiguous capture landing inside the
    7.7 ms NOP prefix, and triggering on /WR from an idle screen (which
    catches displaylcd_setup rath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
    [lcsc-order.csv]
2026-08-03 Two write regimes, a wrong claim corrected, and the init was already captured
    Pure analysis of existing captures -- no bench work, the Phase 6 parts have
    not arrived.
    Resolves the 7-vs-13 window-setup question raised in the previous commit, and
    it resolves against something I asserted there. All 13 writes did happen. D/C
    makes 13 transitions in the pattern 0,1,0,1,...,0 across the region -- one run
    per write, starting and ending on a command, exactly the shape of
    displaylcd_setup() -- while only 7 /WR pulses were sampled.
    CORRECTION: "158 falling edges and 158 rising edges, so no pulse was missed"
    is wrong reasoning. A pulse shorter than the sample interval takes both its
    edges with it, so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
    [seqmatch.py]
2026-10-12 The cold-boot captures never armed: an oversized pre-trigger, not the hardware
    A pre-trigger above 1024 samples makes the analyzer silently fail to arm. It
    reports nothing: TerminalCapture prints the same line whether it is waiting for
    a trigger, downloading, or refusing the configuration, and capture.py ran it
    with no timeout. The failure therefore looks exactly like patience running out.
    Confirmed by controlled test. 20261012_161426 and 20261012_161634 are identical
    - 8 channels, 131071 total samples, same trigger channel, 1 MS/s, same rig and
    session - and differ only in pre-trigger, 65536 against 1024. The first sat
    armed 128 s with TE demonstrably pulsing and never fired; the second co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
    [capture.py]
2026-10-12 Gap 1 answered: the analog domain is powered 218 ms before the logic domain
    First capture of pins 26, 33 and 34 in this project. The original board does
    not bring the panel's supplies up together - it runs two phases, reproduced
    across two cold starts to within one 10 us sample:
    0 3.0 V panel supply (pin 33)
    +0.09 ms pin 32
    +0.13 ms 1.54 V analog reference (pin 34)
    +218.3 ms 1.8 V VDDIO (pin 26), with /WR and /CS
    +218.31 ms pin 30
    Every transition is single and monotonic - no glitching, no brown-out. The
    218.3 ms interval held to 0.005% across boots started by *different*
    mechanisms, battery reconnect and hold-switch release, which rules out software
    jitte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
2026-10-12 Gap 2 answered: first LCD transfer 397 ms after VDDIO, and burst duration is measurable
    Slowed the same wiring to 25 kS/s for a 1.31 s window. Boot display timeline,
    from /CS envelopes, timed from the 3.0 V rail:
    +218.28 ms VDDIO up, /WR and /CS rise with it
    +615.64 ms first LCD transfer - /CS asserted 80 us, the init register block
    +628.12 ms TE starts, 67.91 Hz from its very first pulse
    +877.56 ms /CS asserted 40 us, the init's trailing writes
    +879.52 ms first pixel burst, 23.48 ms
    Gap 2's answer is +397.36 ms after VDDIO, and it imposes no driver requirement
    - that is simply when Rockbox's bootloader got round to it. The delay a driver
    must actually respect is the po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
2026-10-12 Withdraw the pre-trigger explanation: the documented limits say it cannot be right
    b7c0054 claimed an oversized pre-trigger is what makes the analyzer silently
    fail to arm. Upstream publishes exact limits (04/02/2023), and against them the
    claim does not hold. Min pre 2, min post 512, frequency 3.1 kHz to 100 MHz:
    mode max pre max post max total
    8 channels 98 303 131 069 131 071
    16 channels 49 151 65 533 65 535
    24 channels 24 576 32 765 32 767
    So pre=65536 at 8 channels was legal and failed twice; pre=8000 at 24 channels,
    three of the five cold-boot attempts, was legal too. Only the pre=30000 pair
    genuinely exceeded a ceiling.
    The de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
    [capture.py]
2026-10-12 Power-down measured: the exact mirror of power-up, over 46.5 ms
    First capture of the panel losing power. Times relative to VDDIO falling, on a
    Rockbox software shutdown with the charger disconnected:
    0 VDDIO falls; /WR, /CS and D/C fall in the SAME 40 us sample
    +32.88 ms 1.54 V analog reference
    +34.04 ms pin 32
    +46.48 ms 3.0 V panel supply
    +47.08 ms pin 30
    Up is 3.0 V -> reference -> VDDIO; down is VDDIO -> reference -> 3.0 V. The
    rails reverse exactly, so the conservative rule a designer would guess - up in
    one order, down in reverse - is what the hardware actually does. The descent
    takes 46.5 ms against 218 ms rising. All transitions single and monotonic.
    Ver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
2026-10-12 README: surface the power sequencing results on the front page
    The status line and the facts table still described the state before today,
    with no mention of power sequencing in either direction. Adds rows for the
    power-up and power-down order, the first-LCD-write delay, and the measured
    pixel burst duration with its ambiguity intact, and points the reader at the
    RGB666 pair test as the open item that still blocks a driver board.
2026-10-12 Correct the record: today's USB disappearances were unplugs, not drop-outs
    The analyzer vanished from USB twice during the 2026-10-12 session, and I
    recorded one of them in a capture note as a spontaneous drop-out. Both were the
    operator physically unplugging it while changing probe wiring. Fixed the note
    on 20261012_165816 and said so in finding 7, because an unplug and a real
    drop-out are indistinguishable after the fact, and counting unplugs as
    drop-outs would inflate how often the fault is believed to occur.
    Also narrows finding 7's own speculation. It suggested several inconclusive
    cold-boot captures might have been drop-out victims; they were not - all five
    record returncode -2, SIGIN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
2026-10-12 The pairs are replicated on every DATA write, in command mode too
    Re-read the 2026-08-03 init capture split by D/C. In LCD_MODE_P18,
    pins 9/14 and 21/2 are independent on all 82 command writes but
    identical on all 76 data writes, including 24 where the 16-bit map
    predicts they differ. seqmatch never compared pins 9, 10 or 2, so the
    August byte-exact match could not have seen it.
    So writing pixels as command-mode DATA writes does not escape the
    RGB565 expansion, and switching frame mode to P18 buys nothing. Corrects
    FINDINGS 3: the dividing line is D/C, not the LCD_CON mode.
2026-10-12 Mark poisoned captures so content sweeps cannot silently include them
    Finding 13 moved this project from searching captures by intent to searching
    them by content. But a sweep over captures/*.csv.gz has no way to know a file
    is poisoned: 20260802_124256_dryrun completed successfully, reports rc=0, and
    contains plausible-looking data that is wrong, because VREF sat on the 3v3
    switch position and put the shifter threshold above a 1.8 V logic high.
    Demonstrated today rather than hypothesised. A sweep checking whether the SoC
    ever drives the replicated colour-lane pairs apart returned 36 blue-pair
    splits, 29 of them from that single capture. Excluded, the real figure is 7 in
    14 896 writes, all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
    [capio.py, index_captures.py]
2026-10-12 Confirm pair replication at 196x the sample size: 0 red splits in 14 896 writes
    9eb0ba2 concluded the SoC replicates the colour-lane pairs on every data write,
    from 76 writes in one init capture, leaving open whether a word like 0x8000
    might split the red pair. Swept all 28 valid captures carrying the full 18-lane
    set instead of collecting anything new - 14 896 data writes:
    RED P09/P14 21 distinct values, incl. every MSB-set value to 63 0 splits
    BLUE P21/P02 34 distinct values, incl. every MSB-set value to 63 7 (0.047%)
    command writes 139 of 448, expected
    The conclusion holds, and the 0x8000 worry is largely answered on existing
    evide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
2026-10-12 The pair tie is in the lane map: one APB bit drives both pins. Probe cancelled
    Derived the data-write lane map from existing captures instead of running the
    planned single-bit probe. The init matched 152/152 byte-exactly, so every
    captured data write's intended value is known from refs/sequences.json;
    correlating each APB bit against each flex pin across the 73 data writes
    determines the mapping outright.
    bit 0 P25 bit 4 P21+P02 bit 8 P16 bit 12 P12
    bit 1 P24 bit 5 P20 bit 9 P15 bit 13 P11
    bit 2 P23 bit 6 P19 bit 10 P09+P14 bit 14-15 undetermined
    bit 3 P22 bit 7 P18 bit 11 P13
    One APB bit drives both pins of each pair: bit 10 to pins 9 and 14, bi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
2026-10-12 Pin 34 is 1.36 V in operation, not 1.54 V, and the node is weakly driven
    DRIVING.md specified the analog reference as "~1.54 V" as a build target, but
    OPEN-QUESTIONS 2 records that figure being measured with the display flex
    DISCONNECTED - unloaded. Measured with the flex connected and the panel
    running, which is the operating point a driver should copy:
    flex disconnected, board unloaded 1.54 V
    flex connected, panel running, charger connected 1.26 V
    flex connected, panel running, charger disconnected 1.36 V
    Anyone building to 1.54 V would have targeted ~0.2 V high.
    Not brightness dependent: identical with the screen on and off, so with the
    backlight both on a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
2026-10-12 Correct the pin 34 spread: both readings were on battery, not charger-related
    78f5b12 attributed the 0.10 V difference between the two in-operation pin 34
    readings to the charger, citing finding 11. Both readings were taken on battery
    with no charger attached. The collaborator corrected it.
    The attribution was mine and it came from circumstantial fit: finding 11
    concerns this exact pin, so a charger explanation looked immediately plausible,
    and I committed it without checking the condition.
    Corrected in DRIVING.md, OPEN-QUESTIONS 2 and the notebook. The 0.10 V spread
    is now recorded as UNEXPLAINED, with the charger and the backlight both ruled
    out and the remaining candidates named: settli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
2026-10-12 Pin 34: the 0.10 V spread is measurement repeatability, and the tolerance is likely loose
    Nothing changed between the two in-operation readings but re-probing, so the
    0.10 V difference is our measurement uncertainty rather than variation the
    panel experiences. Undisturbed, the panel presumably sees a stable value; a
    megohm-class node simply cannot be read to better than about +/-50 mV by
    touching it with a 10 MOhm meter. Closes the "unexplained" note from e468625.
    Also records a design argument that was missing. The original board drives this
    pin through a 1-2 MOhm source, and nobody feeds a tolerance-critical reference
    that softly - the weak drive is itself evidence the panel is not fussy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
2026-10-12 Rail-timing tool; P21 tracks the analog reference at power-up and power-down
    railseq.py reproduces the gap 1 table exactly and runs the driver's M1
    captures through the same arithmetic. It also shows data lane P21 crossing
    threshold right after VREF on all three cold starts and falling just before it
    at power-down -- unreported, cause unassigned, a deviation the driver won't copy.
    [railseq.py]
2026-10-12 Bus encoding for the driver: 151/151 init writes pin-exact on all 18 lanes
    16-bit value -> D17..D10/D8..D1, plus the SoC's DATA-write pair replication,
    reproduces every aligned write of the iPod's own init capture. The driver can
    present exactly the pin levels the panel has always received. Also: APB bit 5
    is P20, and a 146-write init capture needs loops=3, not 9.
2026-10-13 Correct the APB-bit tables: bit 5 drives P20
    The data-write lane map in DRIVING and FINDINGS listed no pin for bit 5. The
    encoder that matches 151/151 init writes on all 18 lanes places it on P20.
2026-10-13 Breadboard RP2040 driver: wiring, MicroPython/PIO firmware, bring-up plan
    docs/BREADBOARD.md is the build: GPIO map (25 of 26), rails, reference,
    shifters, TE, and gated milestones M1 (rails) -> panel-less bus check -> M2
    (init, TE as the panel's own acceptance) -> M3 (fills, 64-band ramps, the pair
    test). firmware/ runs on MicroPython; tools/drv.py drives it from the host.
    Datasheet lookups shaped it: the TLV9061IDBVR has no SHDN, so the reference is
    interlocked to the 3.0 V rail and held off by a sink-only GPIO; the AP2112's
    60-ohm discharge makes VDDIO fall first on any loss of control.
    Verified on the host only: 26 sequencing checks (mutants caught), 151/151
    pin-exact encoding from the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
